fire1/WaterSystem/Master/readme.md

## Master sketch

*The file structure of the source code is not standard C++ file-structure.*

### CLion

Open this `Master/` folder as the project root. CMake provides autocomplete (`Master_index`) and `arduino-cli` build/upload targets for **Mega 2560**. Details: [AGENTS.md](AGENTS.md) → **CLion / CMake**.
