fire1/WaterSystem/docs/Communication.md

# Long Range UAR/T over two wires

## Overview
This document outlines the setup for a long-range community communication system using two wires, one for power and data (12V), and the other for ground (GND). The system facilitates communication between an AtMega8 microcontroller and an Arduino Mega 2560 over a cable spanning over 50 meters in length. The AtMega8 sends data regarding tank levels to the Arduino Mega 2560 for monitoring and control.

## Components
- AtMega8 Microcontroller
- Arduino Mega 2560
- 12V Power Supply
- 50-Meter Long Cable (2-Wire)
- Tank Level Sensors (JSN-SR04t-v2)

_**Note:** For the lower supply-voltage resistance of R1 should be lowered, \
as an example the 9V power-supply the resistor value needs to be 100ohms._

## Wiring Scheme

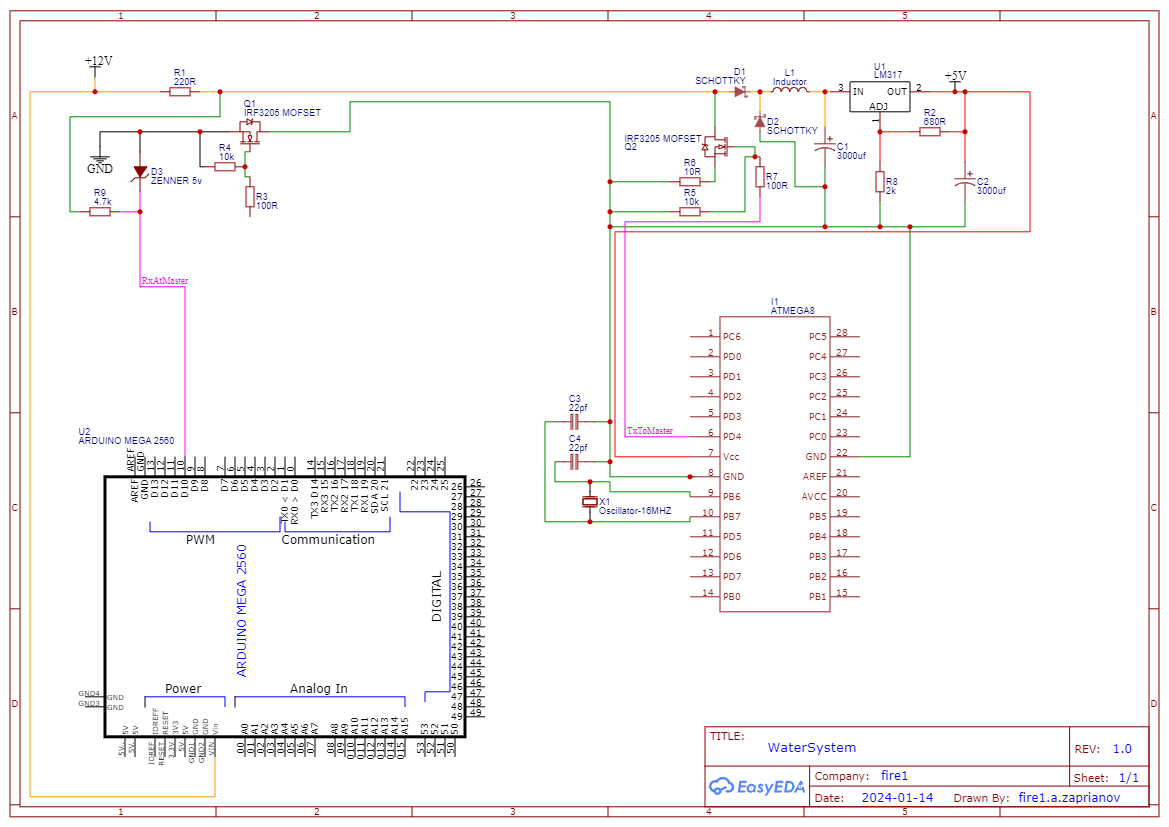
[picture p1: docs/schematics/slave-to-master-long-range.png]
Scheme communication
