fire1/WaterSystem/Master/todo.md

## Todos

- [ ] Switch wellTimer when human interact with well.
