fire1/WaterSystem/Slave/Lib.h

#if DEBUG == 1
#define dbg(x) Serial.print(x)
#define dbgLn(x) Serial.println(x)
#else
#define dbg(x)
#define dbgLn(x)
#endif

#include "lib/SlaveLogic.h"

//
// Map function to map distance values to the range of LEDs
uint8_t mapDistanceToLEDs(uint8_t distance) {
  return slaveLogic::mapDistanceToLeds(distance, minDistance, maxDistance,
                                       numLeds);
}



//
// Lightup the ledbar
void lightUp(int data, unsigned int upTime = 25) {
  //
  // Turn off all LEDs
  for (int i = 0; i < numLeds; i++) {
    digitalWrite(ledPins[i], LOW);
  }
  //
  // Turn on LEDs based on the mapped distance value
  uint8_t ledsToTurnOn = mapDistanceToLEDs(data);
  Serial.print("LD ");
  Serial.println(ledsToTurnOn);
  for (int i = 0; i < ledsToTurnOn; i++) {
    digitalWrite(ledPins[i], HIGH);
    delay(upTime);  // Adjust the delay time as needed
    digitalWrite(ledPins[i], LOW);
  }

  //
  // Turn on the last LED and leave it ON
  digitalWrite(ledPins[ledsToTurnOn], HIGH);
}

//
// Read sensor distance
uint16_t readSensor() {
  digitalWrite(pinTrg, LOW);
  delayMicroseconds(2);
  digitalWrite(pinTrg, HIGH);
  delayMicroseconds(10);
  digitalWrite(pinTrg, LOW);

  float duration = pulseIn(pinEch, HIGH);
  uint16_t distance = slaveLogic::distanceFromPulseUs(
      static_cast<unsigned long>(duration));
  // Serial.print("Distance: ");
  // Serial.println(distance);

  delay(20);
  return distance;
}
