fire1/WaterSystem/Master/tests/test_moon.cpp

/**
 * Host unit tests for moon position and Moon3Mode schedule selection.
 *
 * Build & run (from Master/tests):
 *   make moon_test && ./moon_tests
 */
#include "../lib/Moon.h"
#include "TestHarness.h"

static constexpr float LAT = 42.7f;
static constexpr float LON = 25.5f;

// ---------------------------------------------------------------------------
// Altitude sanity
// ---------------------------------------------------------------------------

TEST(altitude_within_valid_range) {
  float alt = moon::moonAltitudeDeg(2024, 6, 15, 12, 0, LAT, LON);
  EXPECT_TRUE(alt >= -90.f && alt <= 90.f);
}

TEST(full_moon_night_moon_is_above_horizon) {
  // 2024-01-25 ~full moon, 22:00 local Bulgaria
  bool up = moon::isMoonAboveHorizon(2024, 1, 25, 22, 0, LAT, LON, 3.f);
  EXPECT_TRUE(up);
}

TEST(midday_same_date_moon_often_below_horizon) {
  float alt = moon::moonAltitudeDeg(2024, 1, 25, 12, 0, LAT, LON);
  EXPECT_TRUE(alt < 3.f);
}

TEST(horizon_margin_respected) {
  float alt = moon::moonAltitudeDeg(2024, 6, 15, 23, 0, LAT, LON);
  bool up3 = moon::isMoonAboveHorizon(2024, 6, 15, 23, 0, LAT, LON, 3.f);
  if (alt > 3.f)
    EXPECT_TRUE(up3);
  else
    EXPECT_FALSE(up3);
}

// ---------------------------------------------------------------------------
// Schedule selection (Moon3Mode logic)
// ---------------------------------------------------------------------------

TEST(schedule_moon4_rtc_off_uses_4h) {
  auto s = moon::scheduleForTideMoon4(false, 0.f, 0.f, 0.f);
  EXPECT_EQ(s.runtime, moon::MOON_RUNTIME);
  EXPECT_EQ(s.breaktime, moon::MOON_BREAK_4H);
}

TEST(schedule_moon4_tide_high_uses_3h) {
  auto s = moon::scheduleForTideMoon4(true, 0.f, 0.f, 0.f);
  EXPECT_EQ(s.breaktime, moon::MOON_BREAK_3H);
  EXPECT_EQ((int)s.runtime + (int)s.breaktime, 180);
}

TEST(schedule_moon4_mid_gap_targets_half_period) {
  const float w = moon::tideWindowHours(0.f);
  // Lagged HA at low-tide midpoint (|HA|≈6)
  auto s = moon::scheduleForTideMoon4(true, 6.f, 0.f, 0.f);
  const uint16_t expected =
      moon::clampBreakMinutes(moon::haDeltaToMinutes((12.f - w) - 6.f));
  EXPECT_EQ(s.breaktime, expected);
}

TEST(schedule_moon4_approaching_mid_waits_for_midpoint) {
  // |HA|=4 → 2h of HA until mid at 6
  auto s = moon::scheduleForTideMoon4(true, 4.f, 0.f, 0.f);
  const uint16_t expected = moon::clampBreakMinutes(moon::haDeltaToMinutes(2.f));
  EXPECT_EQ(s.breaktime, expected);
}

TEST(schedule_moon4_3h_cycle_totals_180_minutes) {
  auto s = moon::scheduleForTideMoon4(true, 0.f, 0.f, 0.f);
  EXPECT_EQ((int)s.runtime + (int)s.breaktime, 180);
}

TEST(schedule_moon4_4h_fallback_totals_242_minutes) {
  auto s = moon::scheduleForTideMoon4(false, 0.f, 0.f, 0.f);
  EXPECT_EQ((int)s.runtime + (int)s.breaktime, 242);
}

// ---------------------------------------------------------------------------
// Lunar tide (TidRunMode logic)
// ---------------------------------------------------------------------------

TEST(tide_high_near_transit) {
  const float w = moon::TIDE_WINDOW_BASE_HOURS;
  EXPECT_TRUE(moon::isLunarTideHigh(0.f, w));
  EXPECT_TRUE(moon::isLunarTideHigh(1.f, w));
  EXPECT_TRUE(moon::isLunarTideHigh(-1.2f, w));
}

TEST(tide_high_near_nadir) {
  const float w = moon::TIDE_WINDOW_BASE_HOURS;
  EXPECT_TRUE(moon::isLunarTideHigh(12.f, w));
  EXPECT_TRUE(moon::isLunarTideHigh(-11.f, w));
  EXPECT_TRUE(moon::isLunarTideHigh(10.8f, w));
}

TEST(tide_low_midway_between_peaks) {
  const float w = moon::TIDE_WINDOW_BASE_HOURS;
  EXPECT_FALSE(moon::isLunarTideHigh(6.f, w));
  EXPECT_FALSE(moon::isLunarTideHigh(-6.f, w));
  EXPECT_FALSE(moon::isLunarTideHigh(4.f, w));
}

TEST(tide_lag_shifts_peak_detection) {
  EXPECT_TRUE(moon::isLunarTideHighAt(0.f, 0.f, 0.f));
  EXPECT_TRUE(moon::isLunarTideHighAt(2.f, 0.f, 1.f));
  EXPECT_FALSE(moon::isLunarTideHighAt(2.f, 0.f, 0.f));
}

TEST(spring_tide_widens_window_at_full_moon) {
  const float neap = moon::tideWindowHours(0.25f);
  const float spring = moon::tideWindowHours(0.f);
  EXPECT_TRUE(spring > neap);
  EXPECT_TRUE(moon::springTideFactor(0.f) > 0.9f);
  EXPECT_TRUE(moon::springTideFactor(0.25f) < 0.1f);
}

TEST(m2_half_period_matches_noaa) {
  EXPECT_EQ(moon::M2_HALF_PERIOD_MIN, 373);
  EXPECT_EQ((int)moon::M2_PERIOD_MIN, 745);
}

TEST(schedule_tide_rtc_off_uses_4h_break) {
  auto s = moon::scheduleForTide(false, 0.f, 0.f, 0.f);
  EXPECT_EQ(s.runtime, moon::MOON_RUNTIME);
  EXPECT_EQ(s.breaktime, moon::MOON_BREAK_4H);
}

TEST(schedule_tide_low_before_transit_waits_for_peak_window) {
  const float w = moon::tideWindowHours(0.f);
  auto s = moon::scheduleForTide(true, -4.f, 0.f, 0.f);
  const uint16_t expected =
      moon::clampBreakMinutes(moon::haDeltaToMinutes(4.f - w));
  EXPECT_EQ(s.breaktime, expected);
}

TEST(schedule_tide_low_after_transit_waits_for_nadir_peak_window) {
  const float w = moon::tideWindowHours(0.f);
  auto s = moon::scheduleForTide(true, 4.f, 0.f, 0.f);
  const uint16_t expected =
      moon::clampBreakMinutes(moon::haDeltaToMinutes((12.f - w) - 4.f));
  EXPECT_EQ(s.breaktime, expected);
}

TEST(schedule_tide_mid_gap_skips_extra_low_run) {
  const float w = moon::tideWindowHours(0.f);
  auto s = moon::scheduleForTide(true, 6.f, 0.f, 0.f);
  const uint16_t expected =
      moon::clampBreakMinutes(moon::haDeltaToMinutes((12.f - w) - 6.f));
  EXPECT_EQ(s.breaktime, expected);
}

TEST(schedule_tide_near_window_enters_peak_not_submin_break) {
  // Just outside spring transit window (w=1.75): raw wait would be ~10–15 min.
  const float w = moon::tideWindowHours(0.f);
  auto s = moon::scheduleForTide(true, -(w + 0.05f), 0.f, 0.f);
  EXPECT_EQ(s.breaktime, moon::peakBreakMinutes(0.f));
  EXPECT_TRUE(s.breaktime >= moon::MOON_BREAK_PEAK_MIN);

  auto nearNadir = moon::scheduleForTide(true, (12.f - w) - 0.05f, 0.f, 0.f);
  EXPECT_EQ(nearNadir.breaktime, moon::peakBreakMinutes(0.f));
  EXPECT_TRUE(nearNadir.breaktime >= moon::MOON_BREAK_PEAK_MIN);
}

TEST(schedule_tide_break_never_below_peak_min_on_2026_10_31) {
  constexpr float lag = 1.25f; // SITE_TIDE_LAG + TidRun extra
  for (int t = 0; t < 24 * 60; t += 1) {
    const int hour = t / 60;
    const int minute = t % 60;
    auto h = moon::computeTideState(2026, 10, 31, hour, minute, LAT, LON);
    auto sch =
        moon::scheduleForTide(true, h.hourAngleHours, h.phaseFraction, lag);
    auto sch4 = moon::scheduleForTideMoon4(true, h.hourAngleHours,
                                           h.phaseFraction, 1.0f);
    EXPECT_TRUE(sch.breaktime >= moon::MOON_BREAK_PEAK_MIN);
    EXPECT_TRUE(sch4.breaktime >= moon::MOON_BREAK_PEAK_MIN);
  }
}

TEST(schedule_tide_high_uses_adaptive_peak_break) {
  // Spring (phase 0): wider window → break clamped at MOON_BREAK_PEAK_MAX
  auto spring = moon::scheduleForTide(true, 0.f, 0.f, 0.f);
  EXPECT_EQ(spring.breaktime, moon::peakBreakMinutes(0.f));
  EXPECT_EQ(spring.breaktime, moon::MOON_BREAK_PEAK_MAX);
  EXPECT_EQ(spring.runtime, moon::MOON_RUNTIME);

  // Neap (phase 0.25): narrower window → shorter rest than spring max
  auto neap = moon::scheduleForTide(true, 0.f, 0.25f, 0.f);
  EXPECT_EQ(neap.breaktime, moon::peakBreakMinutes(0.25f));
  EXPECT_TRUE(neap.breaktime >= moon::MOON_BREAK_PEAK_MIN);
  EXPECT_TRUE(neap.breaktime < moon::MOON_BREAK_PEAK_MAX);
}

TEST(peak_break_spaces_three_runs_across_window) {
  const float wMin = moon::tideWindowMinutes(0.25f); // neap
  const uint16_t br = moon::peakBreakMinutes(0.25f);
  const float span =
      (float)moon::TIDE_PEAK_TARGET_RUNS * (float)moon::MOON_RUNTIME +
      (float)(moon::TIDE_PEAK_TARGET_RUNS - 1) * (float)br;
  EXPECT_TRUE(fabsf(span - wMin) < 1.5f);
}

// ---------------------------------------------------------------------------
// Phase fraction
// ---------------------------------------------------------------------------

TEST(phase_fraction_in_unit_interval) {
  auto h = moon::computeHorizon(2024, 1, 25, 22, 0, LAT, LON);
  EXPECT_TRUE(h.phaseFraction >= 0.f && h.phaseFraction <= 1.f);
}

TEST(full_moon_phase_near_maximum) {
  auto h = moon::computeHorizon(2024, 1, 25, 22, 0, LAT, LON);
  EXPECT_TRUE(h.phaseFraction > 0.85f);
}

// ---------------------------------------------------------------------------
// DST helper
// ---------------------------------------------------------------------------

TEST(bulgaria_summer_uses_dst) {
  EXPECT_TRUE(moon::isBulgariaDst(2024, 7, 15));
}

TEST(bulgaria_winter_no_dst) {
  EXPECT_FALSE(moon::isBulgariaDst(2024, 1, 15));
}

TEST(dst_clock_action_unset_never_moves) {
  EXPECT_TRUE(moon::dstClockAction(true, moon::DST_FLAG_UNSET) ==
              moon::DstClockAction::None);
  EXPECT_TRUE(moon::dstClockAction(false, moon::DST_FLAG_UNSET) ==
              moon::DstClockAction::None);
}

TEST(dst_clock_action_spring_forward) {
  EXPECT_TRUE(moon::dstClockAction(true, moon::DST_FLAG_WINTER) ==
              moon::DstClockAction::SpringForward);
}

TEST(dst_clock_action_fall_back) {
  EXPECT_TRUE(moon::dstClockAction(false, moon::DST_FLAG_SUMMER) ==
              moon::DstClockAction::FallBack);
}

TEST(dst_clock_action_already_aligned) {
  EXPECT_TRUE(moon::dstClockAction(true, moon::DST_FLAG_SUMMER) ==
              moon::DstClockAction::None);
  EXPECT_TRUE(moon::dstClockAction(false, moon::DST_FLAG_WINTER) ==
              moon::DstClockAction::None);
}

TEST(dst_migrate_seed_triggers_fall_back_in_winter) {
  // First flash after Oct change: calendar winter, RTC still on summer.
  const uint8_t seed = moon::dstMigrateSeedFlag(false);
  EXPECT_TRUE(seed == moon::DST_FLAG_SUMMER);
  EXPECT_TRUE(moon::dstClockAction(false, seed) ==
              moon::DstClockAction::FallBack);
}

TEST(dst_migrate_seed_triggers_spring_forward_in_summer) {
  const uint8_t seed = moon::dstMigrateSeedFlag(true);
  EXPECT_TRUE(seed == moon::DST_FLAG_WINTER);
  EXPECT_TRUE(moon::dstClockAction(true, seed) ==
              moon::DstClockAction::SpringForward);
}

TEST(bulgaria_dst_ended_by_2026_10_31) {
  EXPECT_FALSE(moon::isBulgariaDst(2026, 10, 31));
  EXPECT_TRUE(moon::isBulgariaDst(2026, 10, 24)); // day before last Sunday
  EXPECT_FALSE(moon::isBulgariaDst(2026, 10, 25)); // last Sunday Oct 2026
}

TEST(hour_angle_changes_within_the_hour) {
  auto a = moon::computeHorizon(2026, 8, 28, 1, 0, LAT, LON);
  auto b = moon::computeHorizon(2026, 8, 28, 1, 30, LAT, LON);
  EXPECT_TRUE(fabsf(a.hourAngleHours - b.hourAngleHours) > 0.01f);
}

TEST(tide_schedule_waits_for_transit_after_moon_rise) {
  // Aug 27 2026 ~19:45 local — moon just above horizon, transit still hours away
  auto h = moon::computeHorizon(2026, 8, 27, 19, 45, LAT, LON);
  EXPECT_TRUE(h.altitudeDeg >= 0.f && h.altitudeDeg < 10.f);
  constexpr float lag = 1.25f;
  EXPECT_FALSE(moon::isLunarTideHighAt(h.hourAngleHours, h.phaseFraction, lag));
  auto sch = moon::scheduleForTide(true, h.hourAngleHours, h.phaseFraction, lag);
  EXPECT_TRUE(sch.breaktime > moon::MOON_BREAK_PEAK_MAX);
}

TEST(tide_peak_aligns_with_moon_transit_not_rise) {
  auto rise = moon::computeHorizon(2026, 8, 27, 19, 45, LAT, LON);
  auto transit = moon::computeHorizon(2026, 8, 27, 1, 15, LAT, LON);
  EXPECT_TRUE(transit.altitudeDeg > rise.altitudeDeg + 20.f);
  constexpr float lag = 1.25f;
  EXPECT_FALSE(moon::isLunarTideHighAt(rise.hourAngleHours, rise.phaseFraction, lag));
  EXPECT_TRUE(moon::isLunarTideHighAt(transit.hourAngleHours, transit.phaseFraction,
                                       lag));
}

int main() { return run_test_harness(); }
