fire1/WaterSystem/(commit log)

2024-01-31 Adding daytime check to unlock run pumps
2024-02-09 Fixing unproper type of bank2
    [Slave.ino]
2024-02-12 Update pin map for LCD
2024-02-13 Adding function to read well tank by interrupts
2024-02-14 Adding sensors reads
2024-02-15 Adding interation and pump controlling functions \n\n Now pumps will be able to be turned on/off.
2024-02-16 Limiting to a single pump run /if socond run will be stoped/
2024-02-16 Adding a hartbeat led for the mode of the well pump.
2024-02-17 Adding additional classes for handling pumps
2024-02-17 Update uart document
2024-02-17 Fixing inverted controll of well pump
2024-02-18 Adding a clock \n\n Now clock will handle daytime pumps also Clock menu is added
2024-02-19 Commit after tests / max level block fixed
    [Master.ino]
2024-02-19 Commit after test
    Improvments over read when display is on or pump is started
2024-02-27 Improvments, commit after tests
    Adding UART mode for u-s sensor well
    Improving Slave-Master comunication and increasing the read interval of the Slave
    Changed how sensors are readed, also average value is changed in order to provide more smoot output from the sensors.
2024-02-27 Adding overheating protection and temp sensor read
    [Lib.h]
2024-02-28 Adding a fan speed controll
2024-03-04 Fixing memory leak from Tima class
    [Master.ino]
2024-03-04 Improving main tank read of the sensor
2024-03-06 Adding a sleep led indicator for pin 13 /build in led/
2024-03-07 Adding 2 speed fan control
2024-03-17 Adding next action timer
2024-03-17 Adding Pump schedules
2024-03-17 Fixing temperature readings
2024-03-18 Refactoring, now heat control for SSR is saperated.
2024-03-21 Adding termintated state for controlling pump power.
    Now when there is a terminated state pump will not be turned On automaticaly
2024-03-22 Adding overwrite state for pump control
2024-03-22 Removing pump controll delay
2024-03-24 Adding debug info for next timer action
2024-03-31 Fixing UI issues
    Refresh rate now is ok, also blink cursor is fixed
    [Master.ino]
2024-03-31 Fixing initial run for next action timer
2024-04-02 Fixing fan speed issues with changing PWM speed
    [Master.ino]
2024-04-03 Adjusting the speed of the fan
2024-04-03 Adjusting on/off states of the pumps
2024-04-03 Fixing heat handler
2024-04-16 Providing Main tank reads when reach 22cm.
2024-05-08 Saperating the well timer to on/off
2024-05-10 Changing the well pump schedule
2024-06-01 Adding debug info for timer
2024-06-25 Update RSS temperature
2024-07-03 Lowering the interval for fast pumping
2024-07-18 Increase break time for compressor pump
2024-07-18 Updating pump main levels
2024-07-18 Update temperatures
2024-08-19 Fix initial run of pumps before averaging read
2024-08-20 Resolving an issue
    Well mode needs to have local store in order to reset the schedule timer
2024-08-20 Fixing the timer reset for well schedule
2024-09-08 Adding debug for Main sensor power
2024-09-08 Adjusting the heat controller
2025-02-21 Adding MF52 temperature algorithm
2025-02-22 Fixing temperature display
2025-04-03 Fixing check for low temperature
2025-04-06 Adding overtime work protection all pumps. Adding days of inactivity limitation for the well pump. Adding zed ide settings.
2025-04-17 Adjusting the schedule for well pump
2025-05-04 Switching from termitate to a new pump state called failure for overtime protection.
2025-12-06 Adding mode samples
2026-01-18 improve pump mode well
2026-03-18 Adding all avelable modes
    PidRunMode - Runs well pump without dependence of tanks
    PidTnkMode - Runs Well pump with dependence of Both tanks
2026-06-26 Rename GEMINI.md to AGENTS.md, adding tests
    - Replace `GEMINI.md` with updated `AGENTS.md` containing project docs
    - Add `CMakeLists.txt` for IDE indexing
    - Extract overtime protection logic to `lib/Overtime.h`
    - Add host-side unit tests for safety logic in `tests/`
    [TestHarness.h, test_overtime.cpp]
2026-06-26 Adding Moon dependend mode.
    This commit also added a feature to track the moon to determine tides.
    Adding tests related to the moon mode
2026-06-26 Fix PidRunMode runtime creep for airlift well pump
    The adaptive controller was increasing well runtime when rise missed
    the
    3 cm target, even though long runs deplete the well and the first
    minute
    is compressor spin-up with no water flow.
    Extract airlift-aware helpers (AirliftOpt.h): exclude 1 min startup
    from
    efficiency, cap soft runtime at 10 min, and prefer longer rest over
    longer
    run when under target or depleting. Apply the same logic to
    PidTnkMode.
    Add host unit tests and document behavior in AGENTS.md.
    [test_airlift.cpp]
2026-07-01 Update pumping mode titles for clarity
2026-07-02 Remove 6-Hour mode and update Moon4Mode to tide-based schedule
    - Removed `Hours6Mode` from globals and initialization.
    - Refactored `Moon4Mode` to use tidal hour angles instead of altitude.
    - Updated `Moon4Mode` to a ~3h/4h dynamic cycle based on M2 tide
    windows.
    - Added `haDeltaToMinutes` and `clampBreakMinutes` to `Moon.h` for
    timing.
    - Updated unit tests to verify the new tidal scheduling logic.
2026-07-02 Add main tank stability and leak monitoring
    - Implement `Main.h` to manage scheduled transfers, signal stability
    (spike rejection), and steady-drain leak detection.
    - Add `MelodyLeak` to `Buzz.h` for leak warnings.
    - Integrate leak monitoring into `Rule.h`.
    - Add host unit tests in `tests/test_main.cpp` for scheduling and leak
    logic verification.
    [test_main.cpp]
2026-07-05 Correcting basic values of the pumps
    [test_main.cpp]
2026-08-13 Refactor pumping modes and add WellTopOff logic
    - Simplify mode selection to 4 primary entries
    - Implement EEPROM migration for legacy mode configurations
    - Add `WellTopOff` state tracking to handle well recovery sequences
    - Update `Mode` base class and `Rule` to support the new mode
    architecture
    Refactor pumping modes and add WellTopOff logic
    - Streamline mode selection to four primary options
    - Implement migration for legacy EEPROM mode settings
    - Add `WellTopOff` module to allow continued pumping when the well is
    full
    - Update unit tests to include WellTopOff coverage
2026-08-13 Rename Moon4Mode to Moon3Mode
    Update the lunar pumping strategy to a 3-hour cycle with 2-hour
    tide-peak
    intervals. Refactor class names, file references, and initialization to
    reflect the new cycle timing.
2026-08-24 Refactor TidRunMode to schedule based on lunar tide windows
    Replaced fixed low/high tide break times with dynamic scheduling that
    calculates the time remaining until the next tidal window begins. Added
    a small buffer (TIDE_MODE_EXTRA_LAG_HOURS) to shift pump cycles into the
    rising pressure phase of the tide.
    [test_moon.cpp]
2026-08-28 Refactor lunar calculations and improve mode timer handling
    - Switch to `daysSinceJ2000` for astronomical calculations to maintain
    precision in 32-bit floats.
    - Correct `Mode` timer initialization to preserve active pump states
    during mode transitions.
    - Fix UI timer display logic to prevent negative values.
    - Add host-side unit tests for lunar tide scheduling and horizon
    transitions.
    [test_moon.cpp]
2026-09-03 Correcting moon run gap
    [test_moon.cpp]
2026-10-09 Add host tests and CLion CMake for Master and Slave.
    Extract sensor/Slave logic for host unit tests, and add OS-aware
    Arduino CMake so CLion can index and build via arduino-cli.
2026-10-22 Lowering the noise over uart
2026-10-31 Adding auto adjust of clock shift (witner/summer times)
    Fixing Info time screen, when pump is held off
